ItaloML/caravel-dev-V5-M.2-3lfcc-shield/README.md

# caravel-dev-V5-M.2-3lfcc-shield
Repository for the files of a testing Borad for the 3lfcc project (caravan harness). Due to a previous board for the testing setup being name Test Board the file names stayed like that.
