ItaloML/caravel-dev-V5-M.2-3lfcc-shield/TestBoardV113/TestBoardV113.kicad_pcb

## KiCad design TestBoardV113/TestBoardV113.kicad_pcb (2024-02-01)

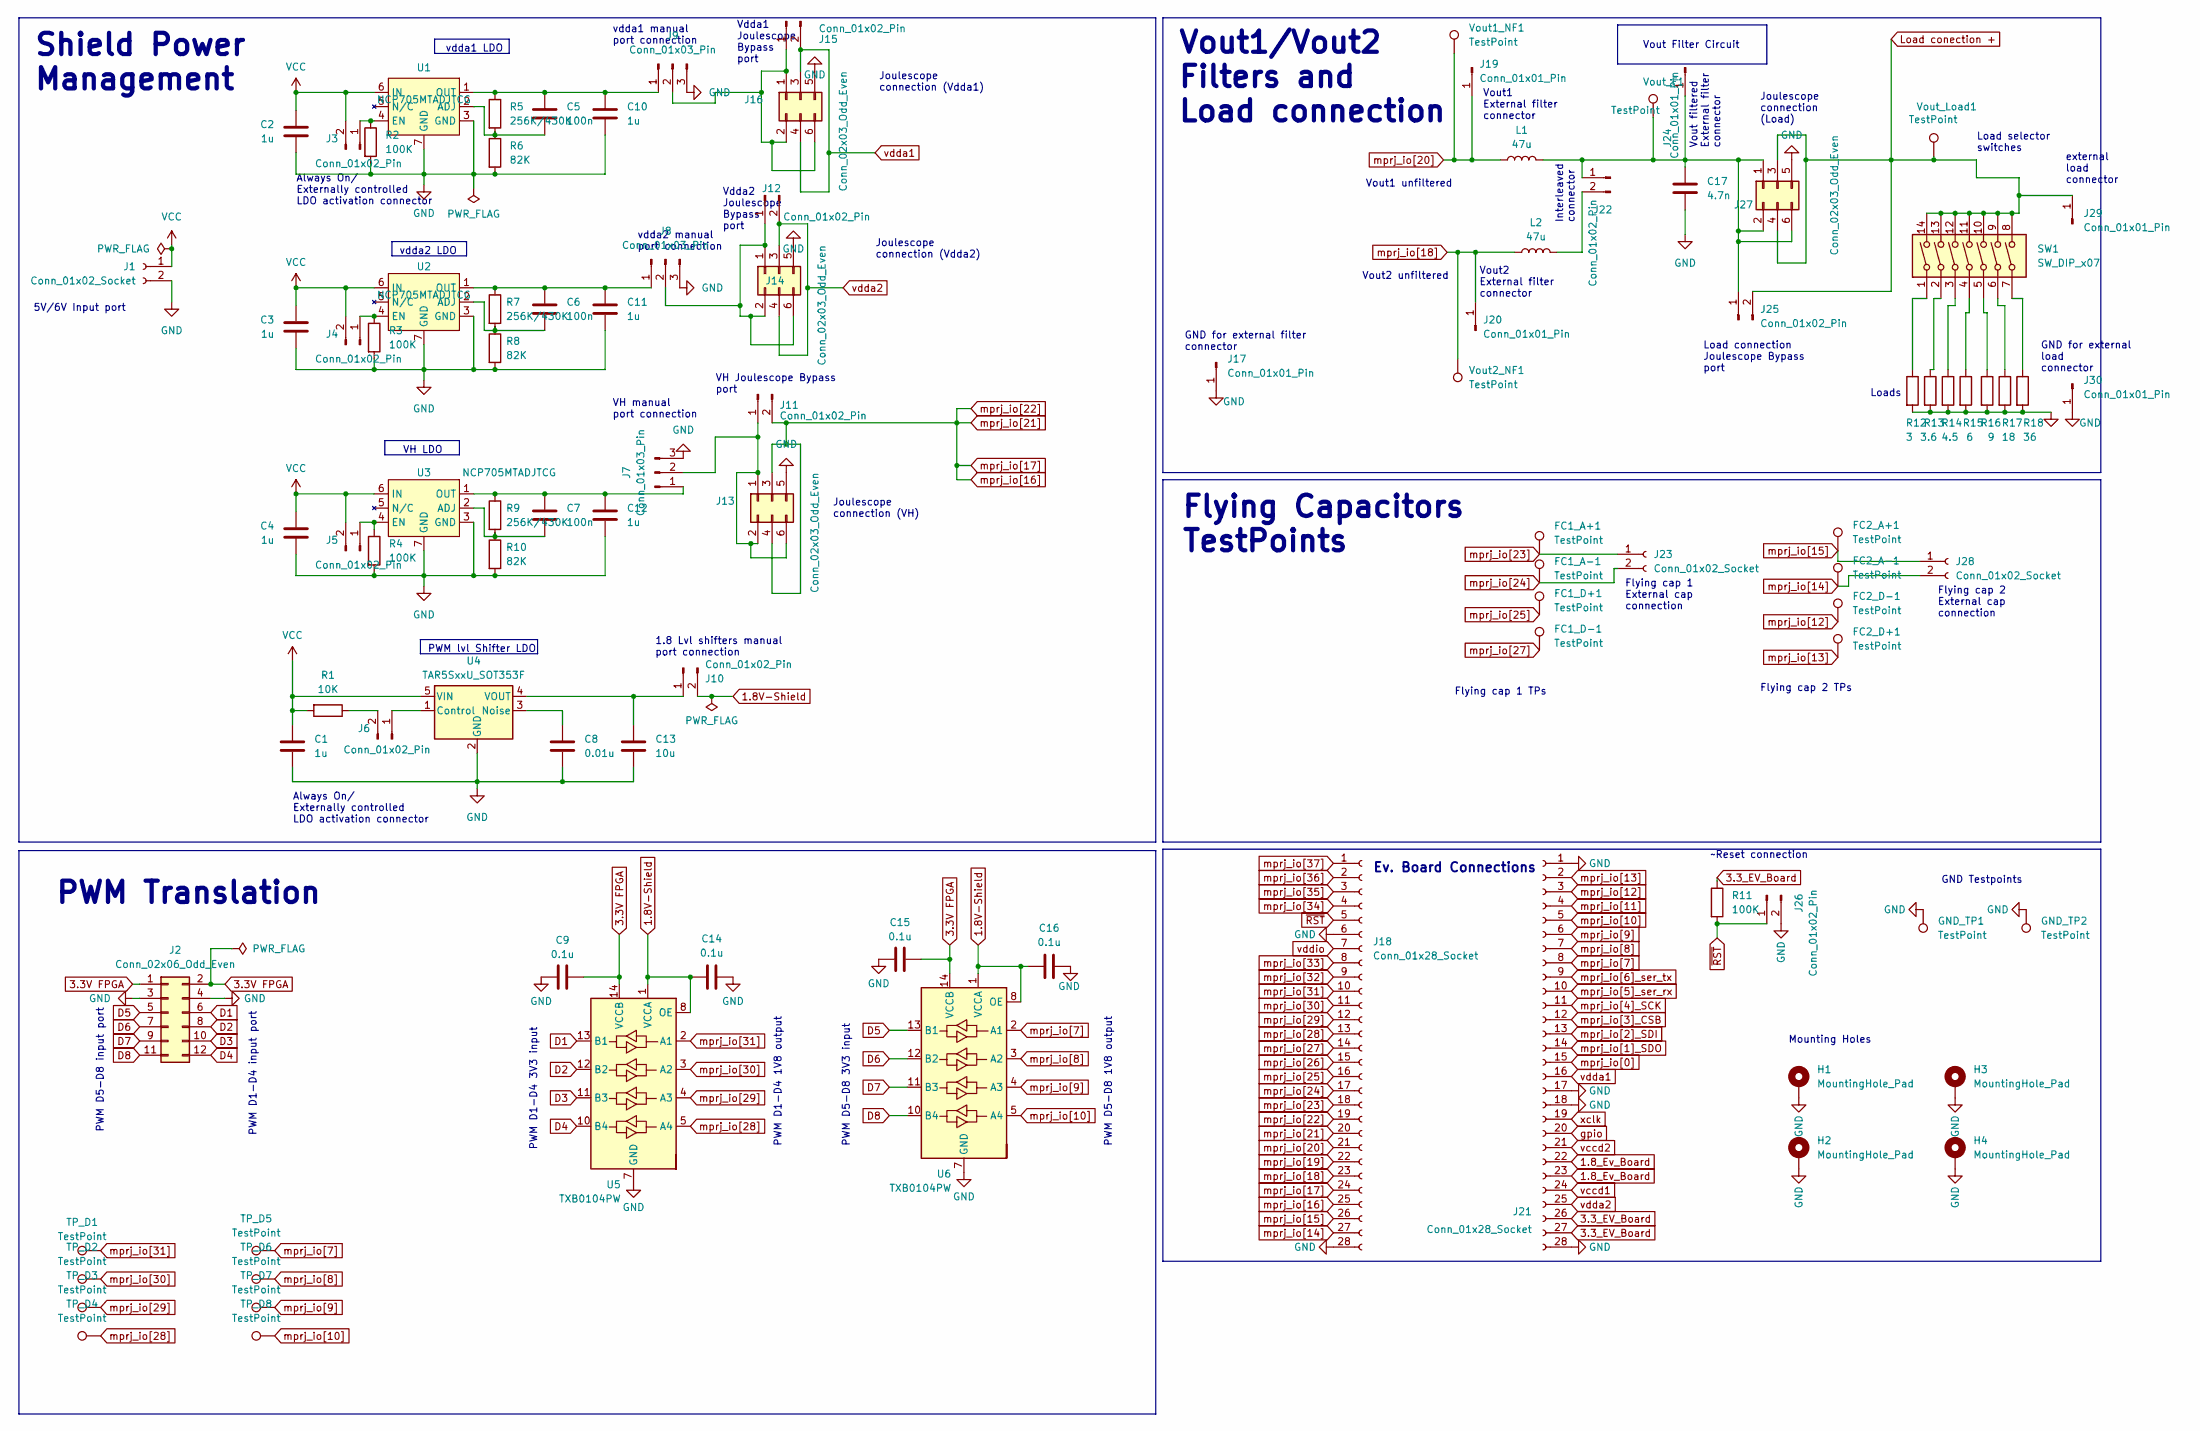
[picture p1: schematic TestBoardV113.kicad_sch]

Parts:
C1, C2, C3, C4, C10, C11, C12: 1u; C_0805_2012Metric
C5, C6, C7: 100n; C_0805_2012Metric
C8: 0.01u; C_0805_2012Metric
C9, C14, C15, C16: 0.1u; C_0805_2012Metric
C13: 10u; C_0805_2012Metric
C17: 4.7n; C_0805_2012Metric
FC1_A+1, FC1_A-1, FC1_D+1, FC1_D-1, FC2_A+1, FC2_A-1, FC2_D+1, FC2_D-1: TestPoint; TestPoint_Keystone_5019_Minature
GND_TP1, GND_TP2: TestPoint; TestPoint_Keystone_5019_Minature
H1, H2, H3, H4: MountingHole_Pad; MountingHole_3.2mm_M3_DIN965_Pad
J1: Conn_01x02_Socket; TerminalBlock_bornier-2_P5.08mm
J2: Conn_02x06_Odd_Even; PinHeader_2x06_P2.54mm_Vertical
J3, J4, J5, J6, J10, J11, J12, J15, J22, J25, J26: Conn_01x02_Pin; PinHeader_1x02_P2.54mm_Vertical
J7, J8, J9: Conn_01x03_Pin; PinHeader_1x03_P2.54mm_Vertical
J13, J14, J16, J27: Conn_02x03_Odd_Even; PinHeader_2x03_P2.54mm_Vertical
J17, J19, J20, J24, J29, J30: Conn_01x01_Pin; PinHeader_1x01_P2.54mm_Vertical
J18, J21: Conn_01x28_Socket; PinSocket_1x28_P2.54mm_Vertical
J23, J28: Conn_01x02_Socket; PinSocket_1x02_P2.54mm_Vertical
L1, L2: 47u; L_1210_3225Metric
R1: 10K; R_0805_2012Metric
R2, R3, R4, R11: 100K; R_0805_2012Metric
R5, R7, R9: 256K/430K; R_0805_2012Metric
R6, R8, R10: 82K; R_0805_2012Metric
R12: 3; R_2010_5025Metric
R13: 3.6; R_2010_5025Metric
R14: 4.5; R_2010_5025Metric
R15: 6; R_2010_5025Metric
R16: 9; R_2010_5025Metric
R17: 18; R_2010_5025Metric
R18: 36; R_2010_5025Metric
SW1: SW_DIP_x07; SW_DIP_SPSTx07_Slide_9.78x19.96mm_W7.62mm_P2.54mm
TP_D1, TP_D2, TP_D3, TP_D4, TP_D5, TP_D6, TP_D7, TP_D8: TestPoint; TestPoint_Keystone_5019_Minature
U1, U2, U3: NCP705MTADJTCG; DFN-6-1EP_2x2mm_P0.65mm_EP1.01x1.7mm
U4: TAR5SxxU_SOT353F; SOT-353F
U5, U6: TXB0104PW; TSSOP-14_4.4x5mm_P0.65mm
Vout1_NF1, Vout2_NF1: TestPoint; TestPoint_Keystone_5019_Minature
Vout_F1: TestPoint; TestPoint_Keystone_5019_Minature
Vout_Load1: TestPoint; TestPoint_Keystone_5019_Minature

Connections:
1.8V-Shield: C14.2, C16.2, J10.2, U5.1 (VCCA), U5.8 (OE), U6.1 (VCCA), U6.8 (OE)
1.8_Ev_Board: J21.22, J21.23
3.3V FPGA: C9.2, C15.2, J2.1, J2.2, U5.14 (VCCB), U6.14 (VCCB)
3.3_EV_Board: J21.26, J21.27, R11.1
D1: J2.6, U5.13 (B1)
D2: J2.8, U5.12 (B2)
D3: J2.10, U5.11 (B3)
D4: J2.12, U5.10 (B4)
D5: J2.5, U6.13 (B1)
D6: J2.7, U6.12 (B2)
D7: J2.9, U6.11 (B3)
D8: J2.11, U6.10 (B4)
GND: C1.2, C2.2, C3.2, C4.2, C8.2, C9.1, C10.2, C11.2, C12.2, C13.2, C14.1, C15.1, C16.1, C17.2, GND_TP1.1, GND_TP2.1, H1.1, H2.1, H3.1, H4.1, J1.2, J2.3, J2.4, J7.3, J8.3, J9.3, J13.5, J14.5, J16.5, J17.1, J18.6, J18.28, J21.1, J21.17, J21.18, J21.28, J26.2, J27.5, J30.1, R2.2, R3.2, R4.2, R6.2, R8.2, R10.2, R12.2, R13.2, R14.2, R15.2, R16.2, R17.2, R18.2, U1.3 (GND), U1.7 (GND), U2.3 (GND), U2.7 (GND), U3.3 (GND), U3.7 (GND), U4.2 (GND), U5.7 (GND), U6.7 (GND)
Load conection +: J25.2, J27.3, J27.4, J29.1, SW1.8, SW1.9, SW1.10, SW1.11, SW1.12, SW1.13, SW1.14, Vout_Load1.1
unnamed: J3.1, R2.1, U1.4 (EN)
unnamed: J4.1, R3.1, U2.4 (EN)
unnamed: J5.1, R4.1, U3.4 (EN)
unnamed: J6.1, U4.1 (Control)
unnamed: J6.2, R1.1
unnamed: C7.1, C12.1, J7.1, R9.1, U3.1 (OUT)
unnamed: C6.1, C11.1, J8.1, R7.1, U2.1 (OUT)
unnamed: C5.1, C10.1, J9.1, R5.1, U1.1 (OUT)
unnamed: C13.1, J10.1, U4.4 (VOUT)
unnamed: J7.2, J11.1, J13.1, J13.2, J13.6
unnamed: J8.2, J12.1, J14.1, J14.2, J14.6
unnamed: J9.2, J15.1, J16.1, J16.2, J16.6
unnamed: C17.1, J22.1, J24.1, J25.1, J27.1, J27.2, J27.6, L1.2, Vout_F1.1
unnamed: J22.2, L2.2
unnamed: R12.1, SW1.1
unnamed: R13.1, SW1.2
unnamed: R14.1, SW1.3
unnamed: R15.1, SW1.4
unnamed: R16.1, SW1.5
unnamed: R17.1, SW1.6
unnamed: R18.1, SW1.7
unnamed: C5.2, R5.2, R6.1, U1.2 (ADJ)
unnamed: C6.2, R7.2, R8.1, U2.2 (ADJ)
unnamed: C7.2, R9.2, R10.1, U3.2 (ADJ)
unnamed: C8.1, U4.3 (Noise)
VCC: C1.1, C2.1, C3.1, C4.1, J1.1, J3.2, J4.2, J5.2, R1.2, U1.6 (IN), U2.6 (IN), U3.6 (IN), U4.5 (VIN)
gpio: J21.20
mprj_io[0]: J21.15
mprj_io[1]_SDO: J21.14
mprj_io[2]_SDI: J21.13
mprj_io[3]_CSB: J21.12
mprj_io[4]_SCK: J21.11
mprj_io[5]_ser_rx: J21.10
mprj_io[6]_ser_tx: J21.9
mprj_io[7]: J21.8, TP_D5.1, U6.2 (A1)
mprj_io[8]: J21.7, TP_D6.1, U6.3 (A2)
mprj_io[9]: J21.6, TP_D7.1, U6.4 (A3)
mprj_io[10]: J21.5, TP_D8.1, U6.5 (A4)
mprj_io[11]: J21.4
mprj_io[12]: FC2_D-1.1, J21.3
mprj_io[13]: FC2_D+1.1, J21.2
mprj_io[14]: FC2_A-1.1, J18.27, J28.2
mprj_io[15]: FC2_A+1.1, J18.26, J28.1
mprj_io[16]: J11.2, J13.3, J13.4, J18.19, J18.20, J18.24, J18.25
mprj_io[18]: J18.23, J20.1, L2.1, Vout2_NF1.1
mprj_io[19]: J18.22
mprj_io[20]: J18.21, J19.1, L1.1, Vout1_NF1.1
mprj_io[23]: FC1_A+1.1, J18.18, J23.1
mprj_io[24]: FC1_A-1.1, J18.17, J23.2
mprj_io[25]: FC1_D+1.1, J18.16
mprj_io[26]: J18.15
mprj_io[27]: FC1_D-1.1, J18.14
mprj_io[28]: J18.13, TP_D4.1, U5.5 (A4)
mprj_io[29]: J18.12, TP_D3.1, U5.4 (A3)
mprj_io[30]: J18.11, TP_D2.1, U5.3 (A2)
mprj_io[31]: J18.10, TP_D1.1, U5.2 (A1)
mprj_io[32]: J18.9
mprj_io[33]: J18.8
mprj_io[34]: J18.4
mprj_io[35]: J18.3
mprj_io[36]: J18.2
mprj_io[37]: J18.1
vccd1: J21.24
vccd2: J21.21
vdda1: J15.2, J16.3, J16.4, J21.16
vdda2: J12.2, J14.3, J14.4, J21.25
vddio: J18.7
xclk: J21.19
~RST: J18.5, J26.1, R11.2

Notes on the sheet:
vdda2 LDO
PWM D1-D4 input port
Always On/ Externally controlled LDO activation connector
Shield Power Management
Vout filtered External filter connector
Mounting Holes
external load connector
PWM D1-D4 3V3 input
Vout2 External filter connector
Vout1 External filter connector
Vdda2 Joulescope Bypass port
PWM D5-D8 3V3 input
Loads
GND for external load connector
vdda1 LDO
vdda2 manual port connection
~Reset connection
Flying cap 1 TPs
Flying cap 2 TPs
Flying Capacitors TestPoints
Interleaved connector
Joulescope connection (Vdda1)
VH Joulescope Bypass port
PWM D1-D4 1V8 output
Flying cap 1 External cap connection
Load connection Joulescope Bypass port
Load selector switches
PWM D5-D8 1V8 output
Flying cap 2 External cap connection
GND for external filter connector
Vdda1 Joulescope Bypass port
PWM Translation
Vout2 unfiltered
VH manual port connection
PWM lvl Shifter LDO
PWM D5-D8 input port
Joulescope connection (Vdda2)
1.8 Lvl shifters manual port connection
Joulescope connection (VH)
Vout Filter Circuit
VH LDO
vdda1 manual port connection
Vout1 unfiltered
Ev. Board Connections
5V/6V Input port
Vout1/Vout2 Filters and Load connection
Joulescope connection (Load)
GND Testpoints

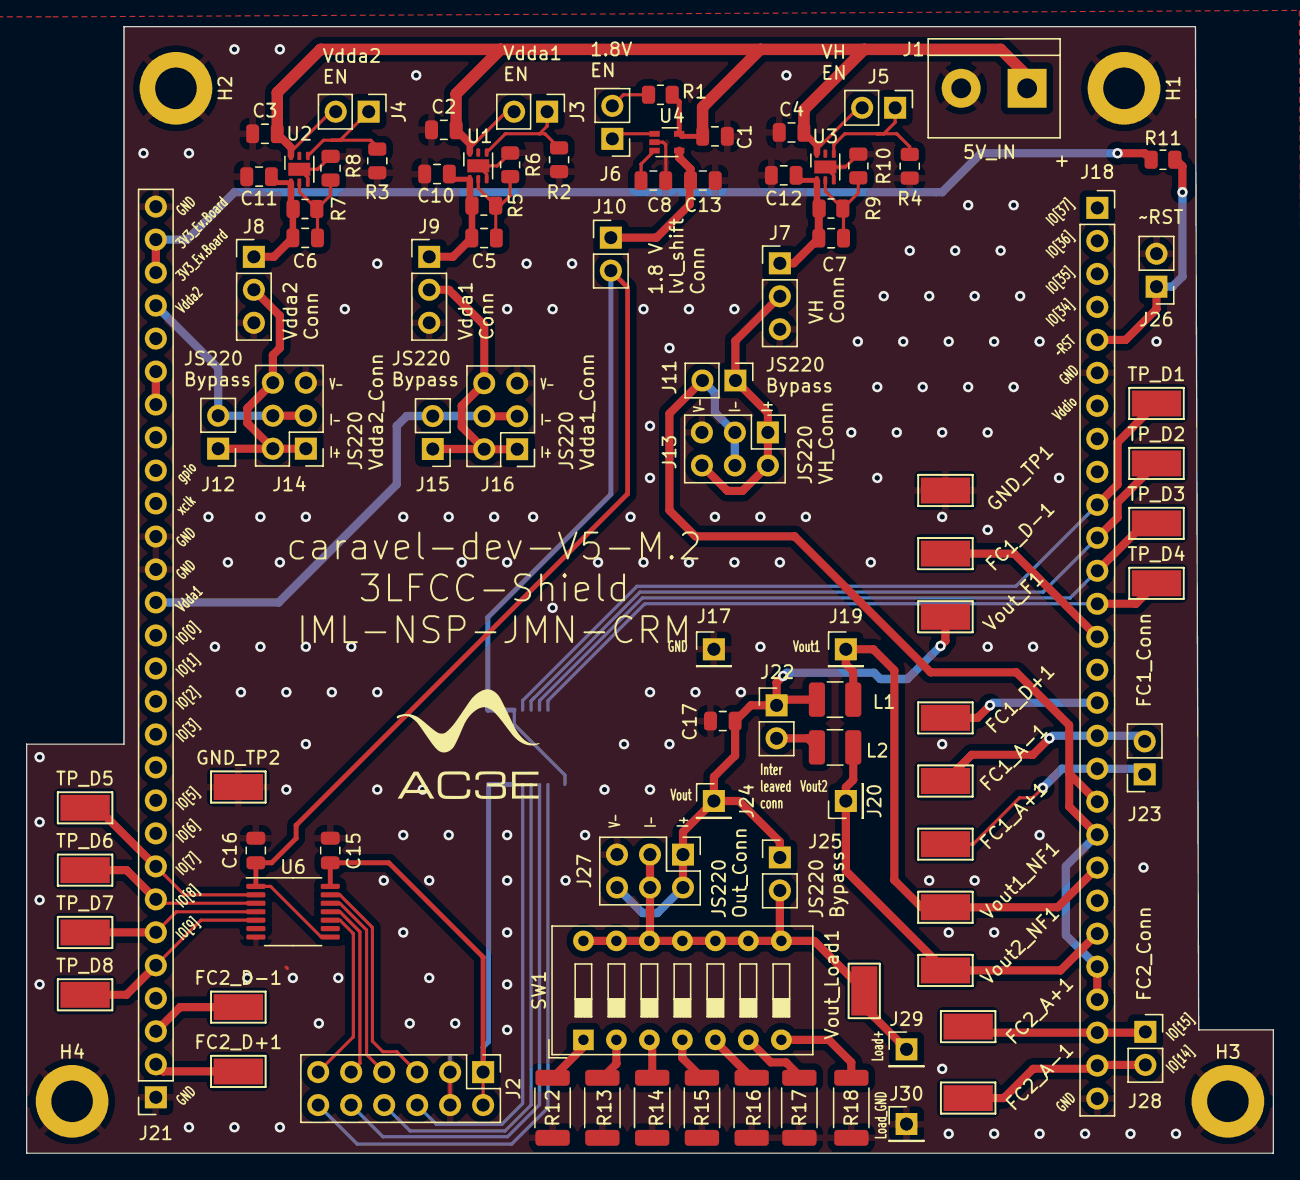
[picture p2: board TestBoardV113.kicad_pcb from above]

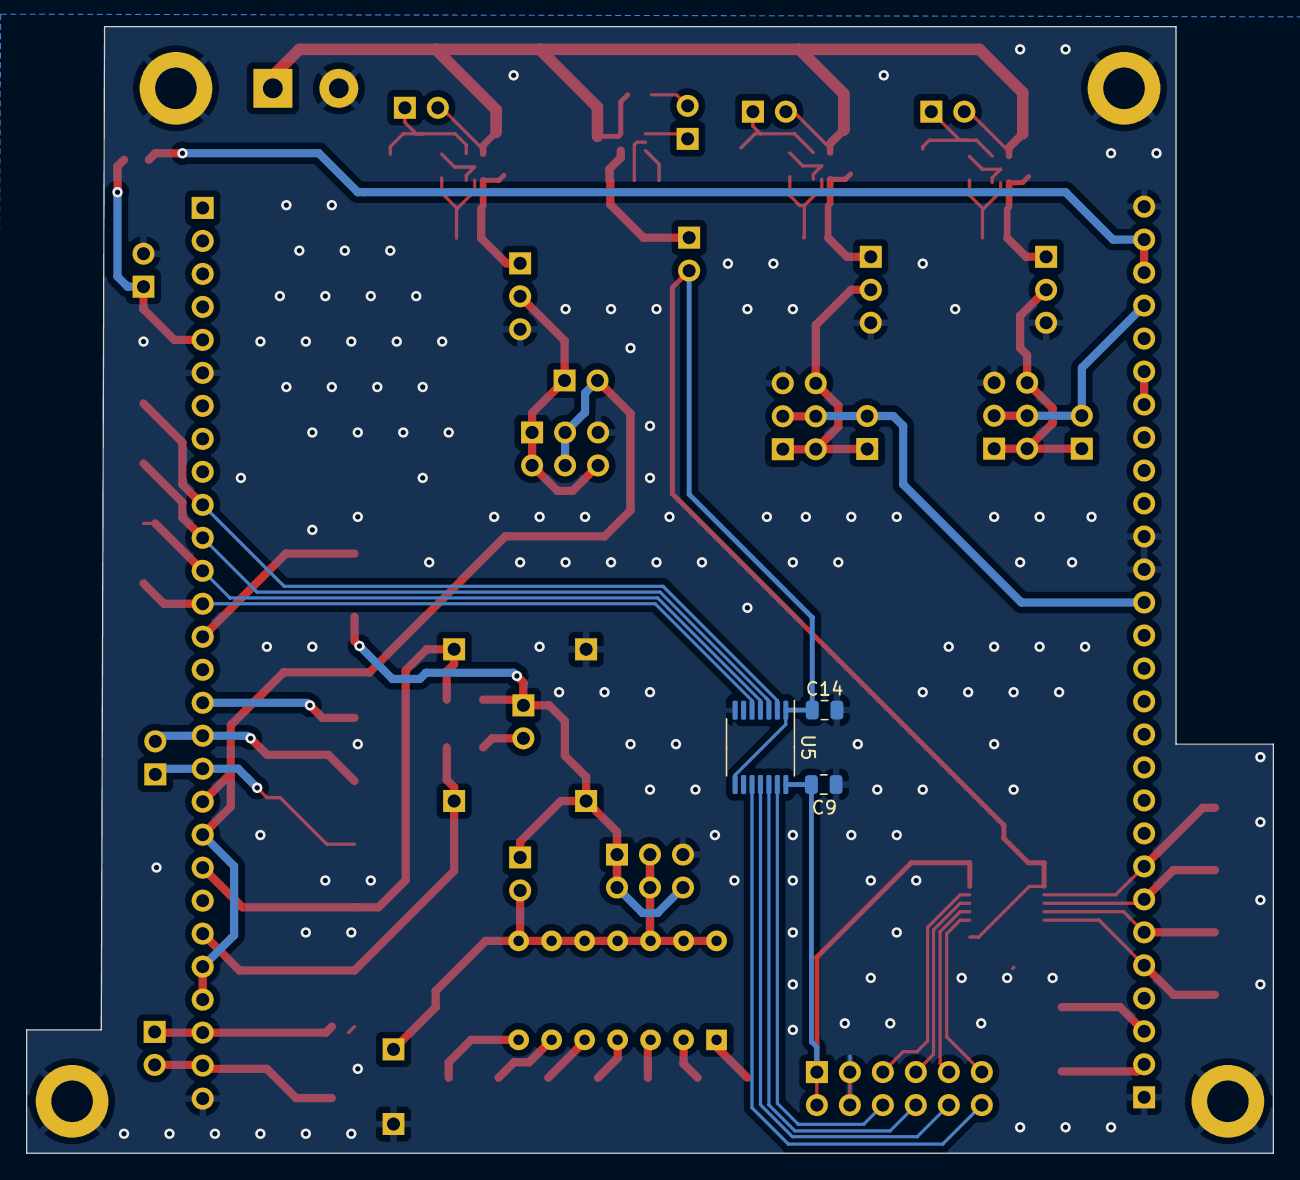
[picture p3: board TestBoardV113.kicad_pcb from below]

Board: 2 copper layers, 96.0 x 86.8 mm, 100 parts (3 on the bottom side), 62 nets.
