ItaloML/caravel-dev-V5-M.2-3lfcc-shield/(commit log)

2024-01-26 First Commit of files
    First Commit of the 3lfcc(TestBoard V1.1.3) files
    [TestBoardV113.csv, TestBoardV113.kicad_pcb, TestBoardV113.kicad_sch, TestBoardV113_BOM.csv]
2024-01-26 Added features
    Added Joulescope port for efficiency measurement with and without level shifters
    [TestBoardV113.kicad_pcb, TestBoardV113.kicad_sch]
2024-01-29 Changed Items
    Changed dip switch from 4
    [TestBoardV113.kicad_pcb, TestBoardV113.kicad_sch]
2024-01-29 Changed Items
    Added independent joulescope connection for vdda1 and 2, added testpoints for 1.8V pwm signals
    [TestBoardV113.kicad_pcb, TestBoardV113.kicad_sch]
2024-01-29 Minor errors
    [TestBoardV113.kicad_pcb]
2024-01-29 Changes
    Test Resistors from 0805 to 2010
    [TestBoardV113.kicad_pcb, TestBoardV113.kicad_sch]
2024-01-30 Changes
    added real resistances values for the dip switch resistances and made the schematic more clear to read. Changed the fpga connector footprint for D1-D8 to avoid warnings
    [TestBoardV113.kicad_pcb, TestBoardV113.kicad_sch]
2024-01-31 Changes
    increased tracks width, change some component placements for better dynamic response, added a connection to ground for vdda1, vdda2 and VH
    [TestBoardV113.kicad_pcb, TestBoardV113.kicad_sch]
2024-01-31 pull up for ~reset
    Added pull-up resistor (100K) for ~Reset
    [TestBoardV113.kicad_pcb, TestBoardV113.kicad_sch]
2024-01-31 Changes
    Added labels
    [TestBoardV113.kicad_pcb]
2024-01-31 new saved file
    [TestBoardV113.kicad_pcb]
2024-01-31 Changed some names
    [TestBoardV113.csv, TestBoardV113.kicad_pcb, TestBoardV113.kicad_sch]
2024-01-31 added external load connector
    [TestBoardV113.csv, TestBoardV113.kicad_pcb, TestBoardV113.kicad_sch]
2024-01-31 size cchanges
    [TestBoardV113.csv, TestBoardV113.kicad_pcb]
2024-02-01 inductors size changed
    [TestBoardV113.kicad_pcb, TestBoardV113.kicad_sch]
